FBIopeningUPP/air-split/docs/images/case_joined_top.png

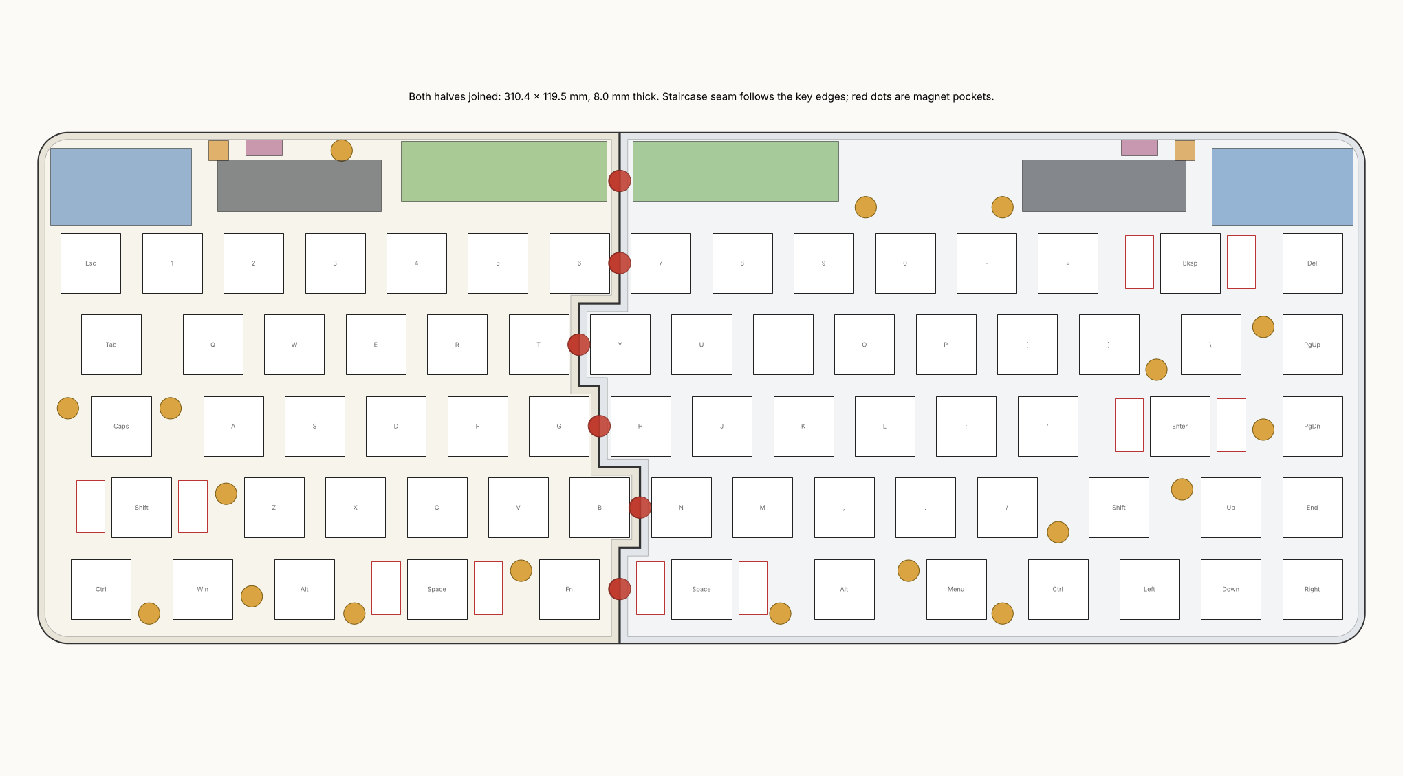
docs/images/case_joined_top.png
