FBIopeningUPP/air-split/docs/images/case_left_top.png

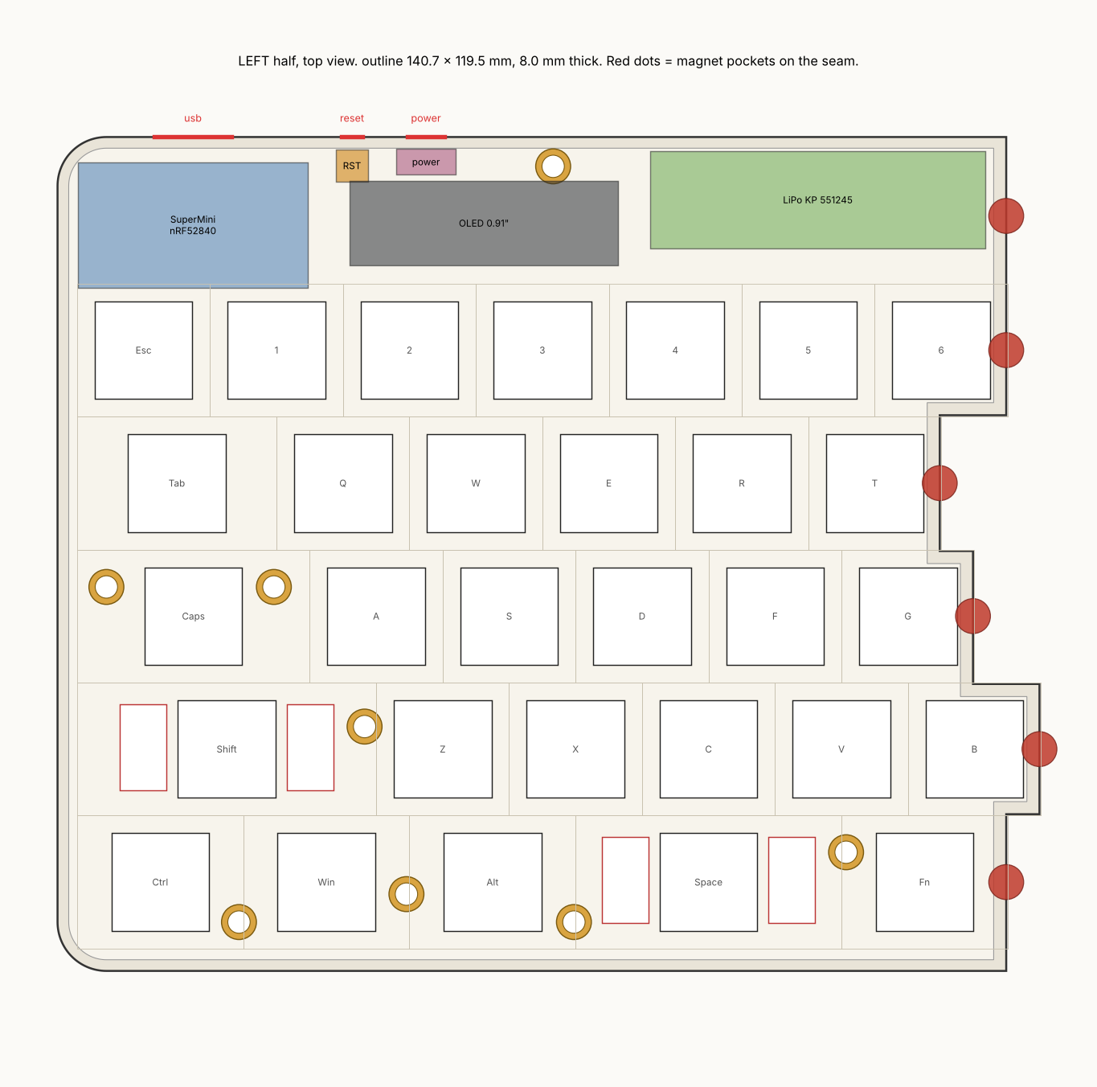
docs/images/case_left_top.png
