FBIopeningUPP/air-split/docs/images/case_right_top.png

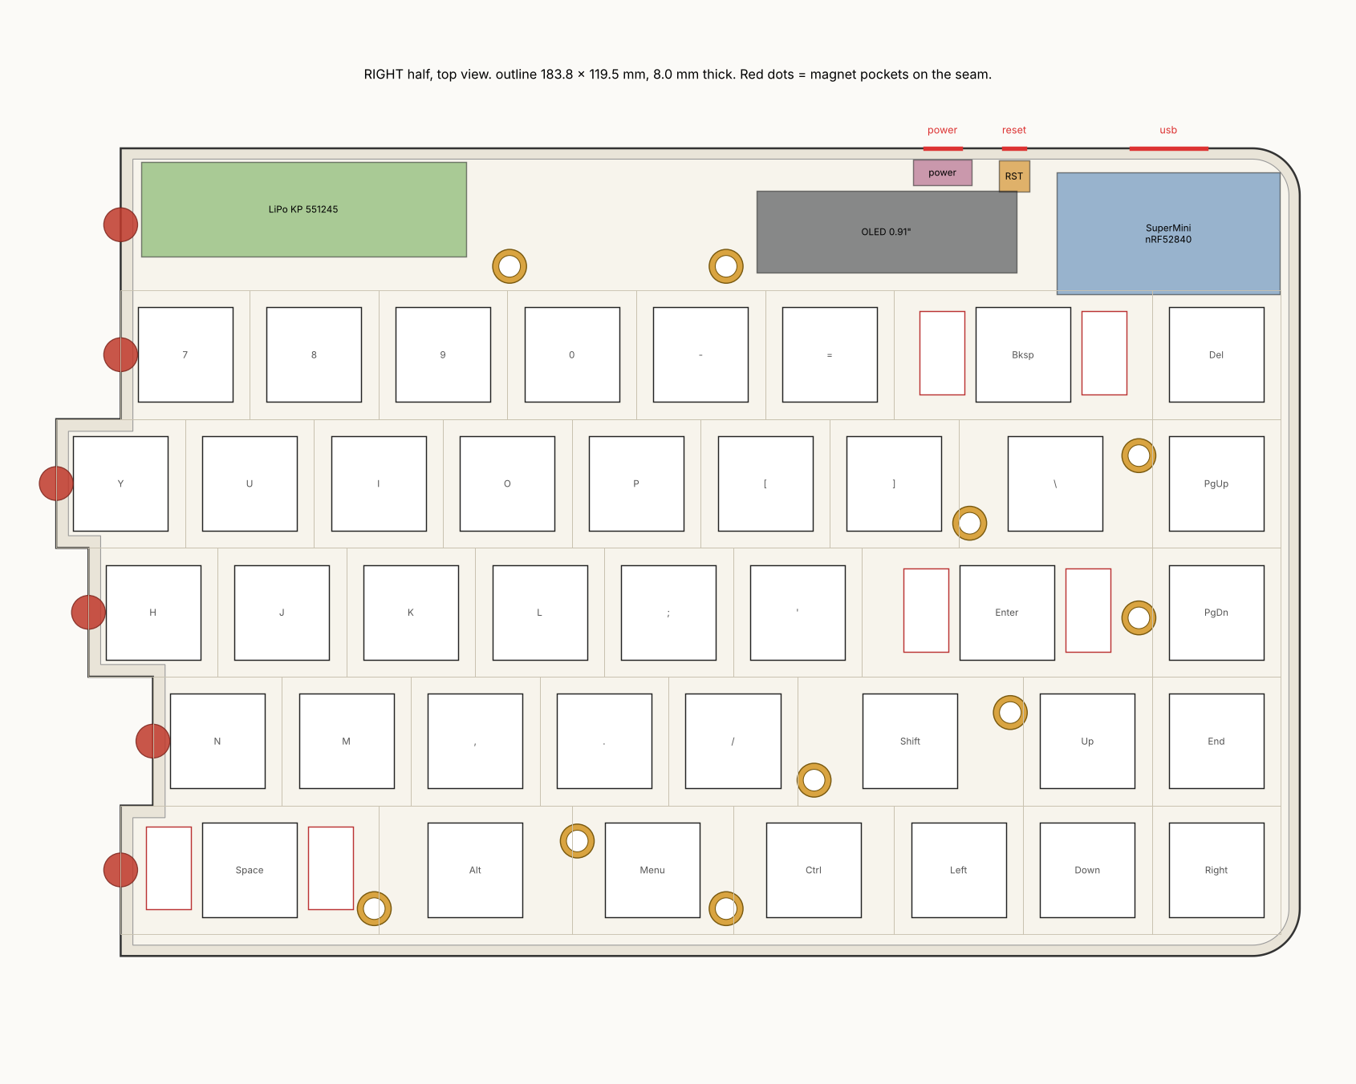
docs/images/case_right_top.png
