FBIopeningUPP/air-split/docs/images/hero.jpg

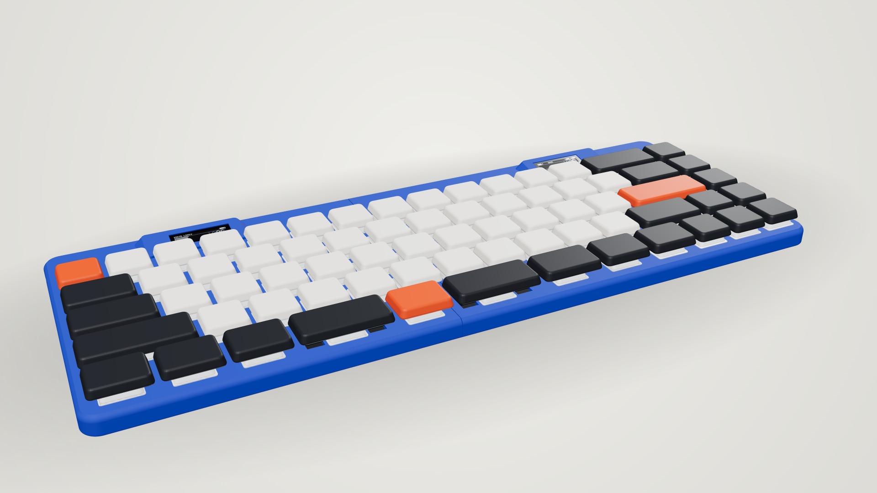
docs/images/hero.jpg
