FBIopeningUPP/air-split/docs/images/thickness_profile.png

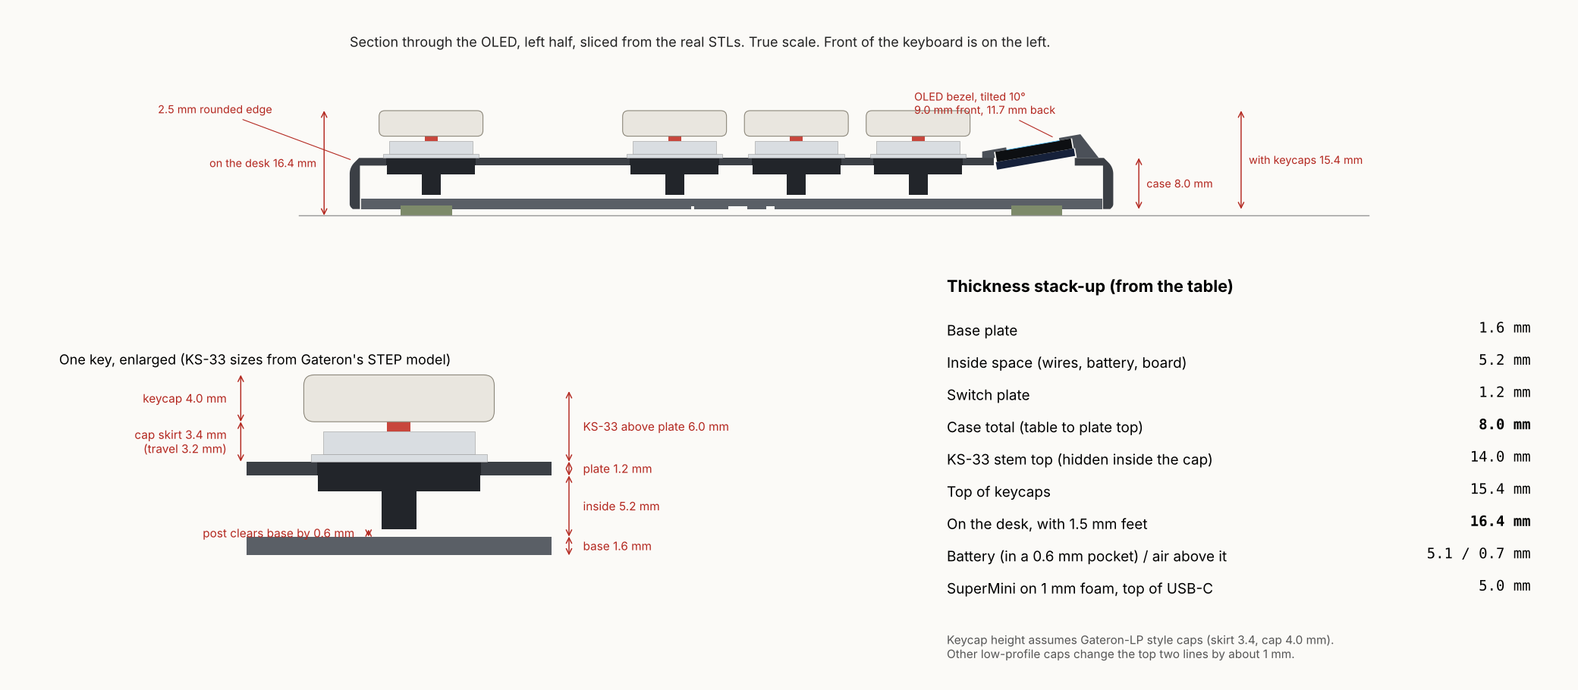
docs/images/thickness_profile.png
