FBIopeningUPP/air-split/models/step/left_base.step

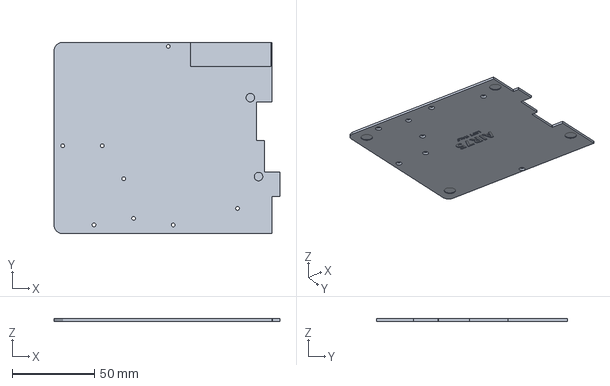
[picture p21: CAD file, 2026-10-18]
models/step/left_base.step
137.0 x 115.9 x 1.60 mm
