FBIopeningUPP/air-split/models/step/right_tent_15.step

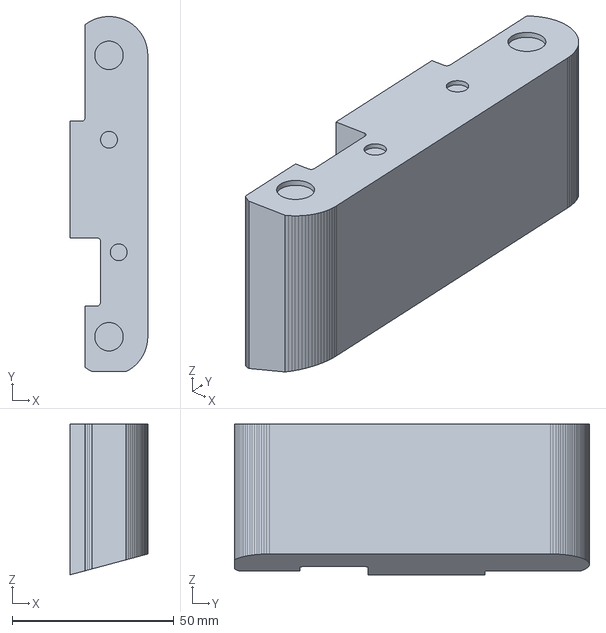
[picture p22: CAD file, 2026-10-18]
models/step/right_tent_15.step
24.0 x 109.8 x 46.6 mm
