FBIopeningUPP/air-split/models/step/left_tent_10.step

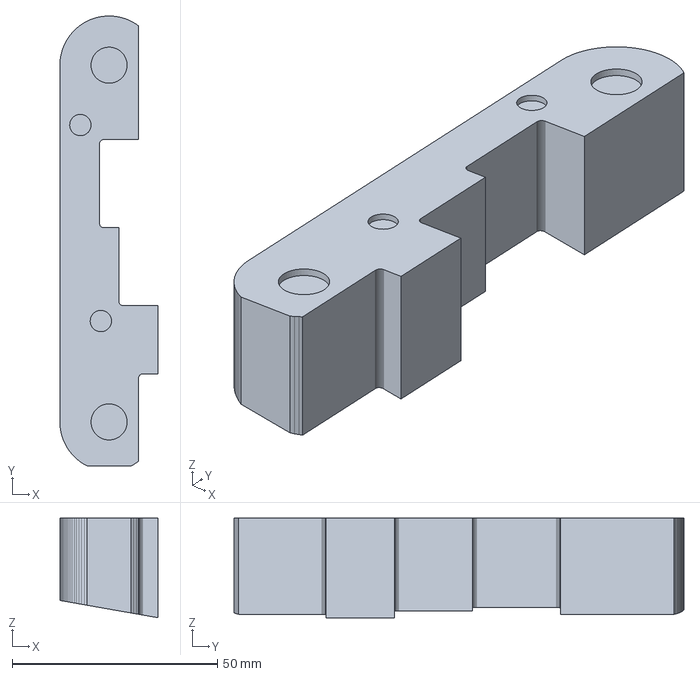
[picture p23: CAD file, 2026-10-18]
models/step/left_tent_10.step
24.0 x 109.8 x 24.3 mm
