FBIopeningUPP/air-split/models/step/fit_test_plate.step

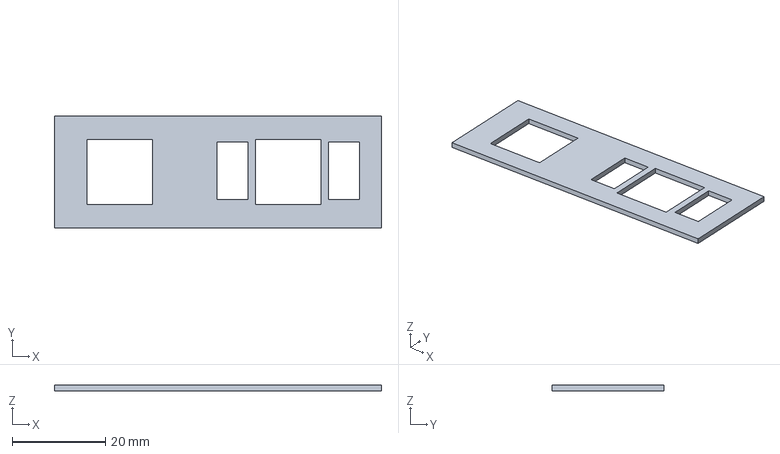
[picture p24: CAD file, 2026-10-18]
models/step/fit_test_plate.step
70.0 x 24.0 x 1.20 mm
