FBIopeningUPP/air-split/models/step/left_tent_15.step

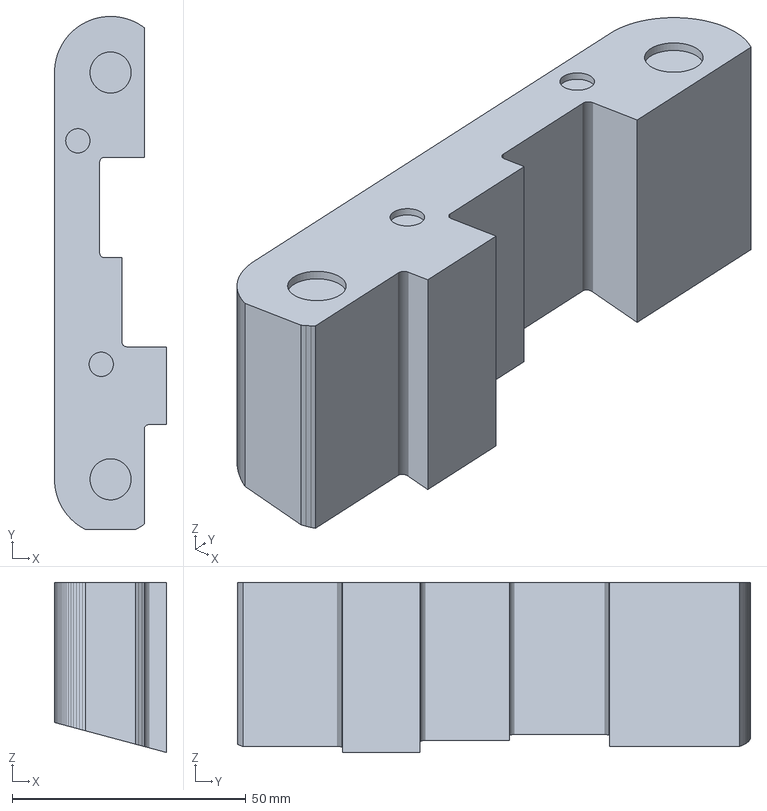
[picture p25: CAD file, 2026-10-18]
models/step/left_tent_15.step
24.0 x 109.8 x 36.4 mm
