FBIopeningUPP/air-split/models/step/left_tent_5.step

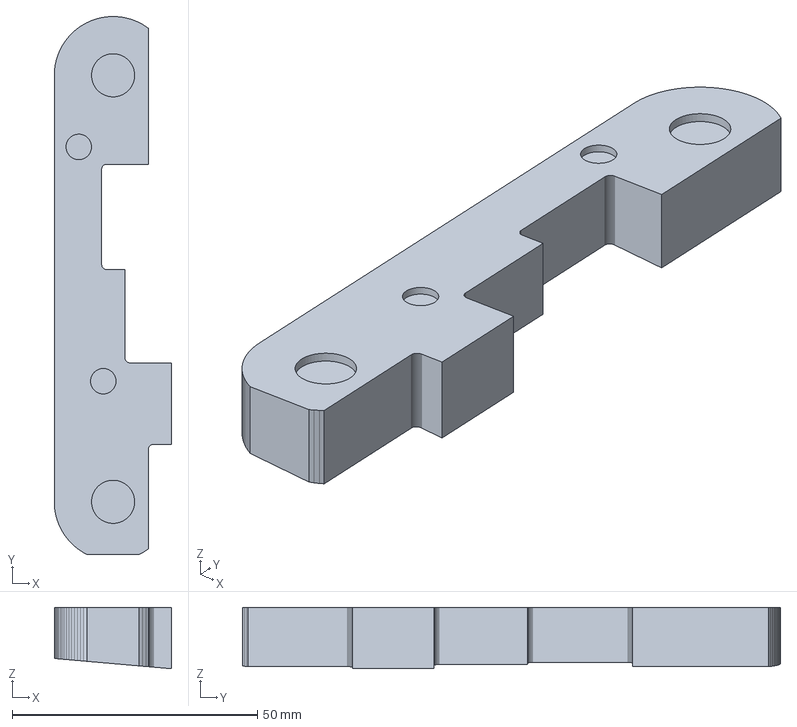
[picture p26: CAD file, 2026-10-18]
models/step/left_tent_5.step
24.0 x 109.8 x 12.5 mm
