FBIopeningUPP/air-split/models/step/left_cover.step

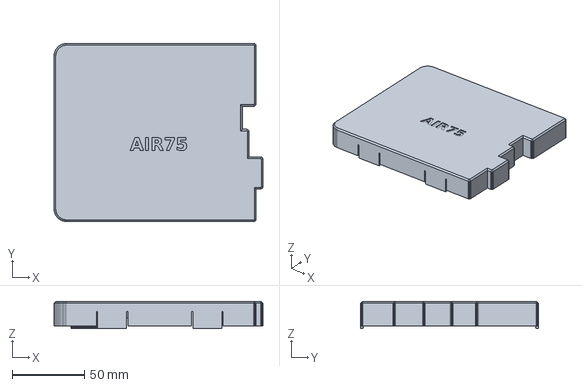
[picture p27: CAD file, 2026-10-18]
models/step/left_cover.step
144.4 x 123.2 x 18.7 mm
