FBIopeningUPP/air-split/models/step/right_cover.step

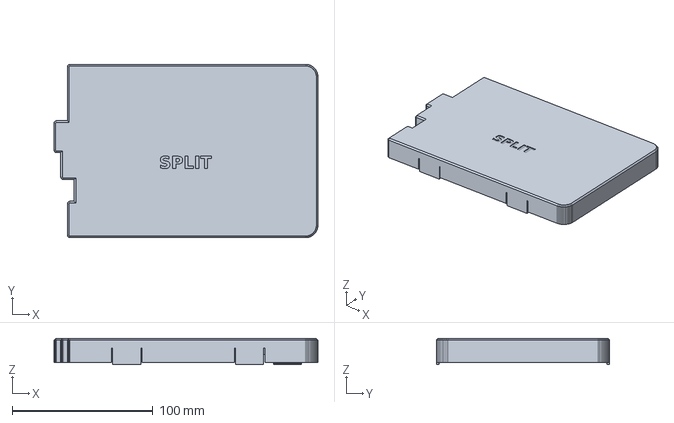
[picture p28: CAD file, 2026-10-18]
models/step/right_cover.step
187.5 x 123.2 x 18.7 mm
