FBIopeningUPP/air-split/models/step/right_oled_bezel.step

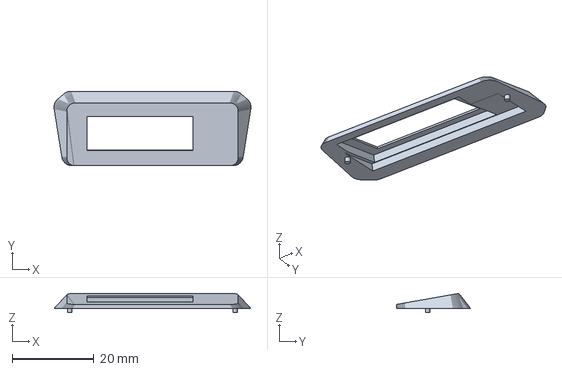
[picture p29: CAD file, 2026-10-18]
models/step/right_oled_bezel.step
48.3 x 18.2 x 4.71 mm
