FBIopeningUPP/air-split/models/step/right_shell.step

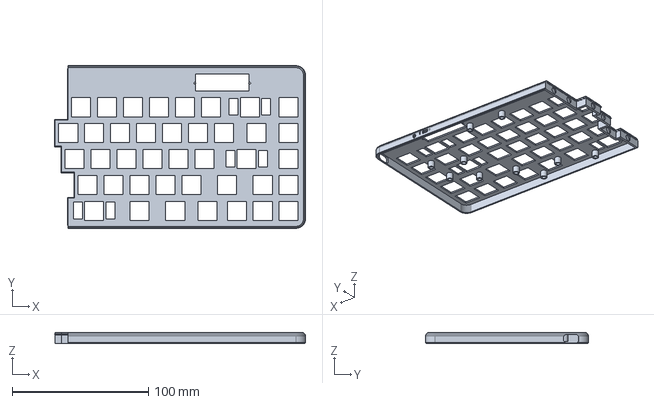
[picture p30: CAD file, 2026-10-18]
models/step/right_shell.step
184.3 x 119.4 x 8.00 mm
