FBIopeningUPP/air-split/models/step/right_tent_10.step

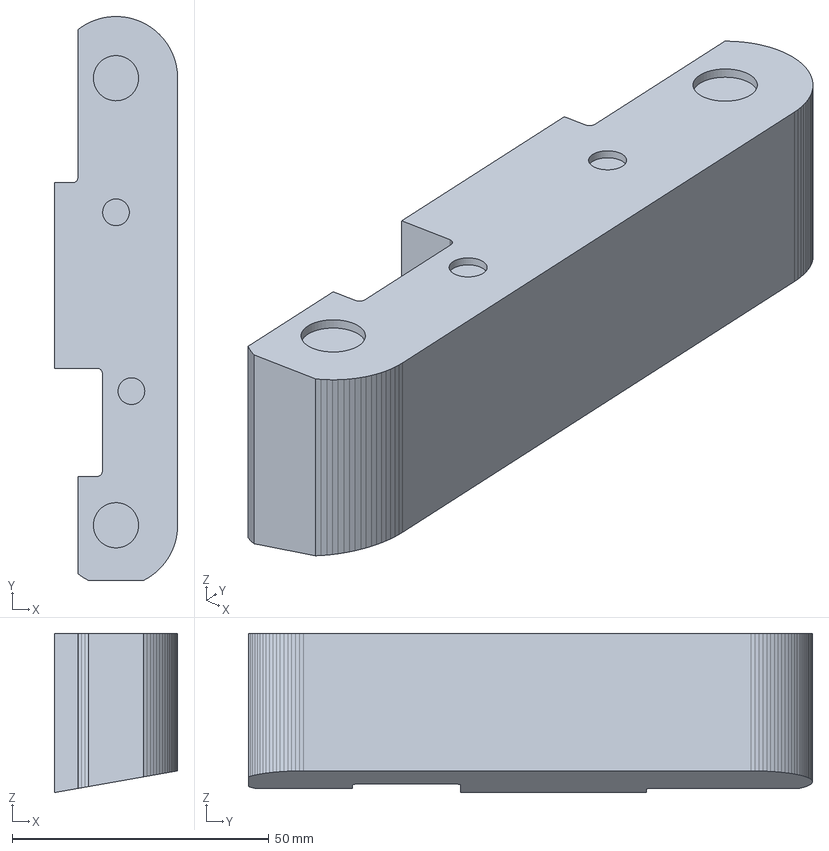
[picture p31: CAD file, 2026-10-18]
models/step/right_tent_10.step
24.0 x 109.8 x 31.0 mm
