FBIopeningUPP/air-split/models/step/left_shell.step

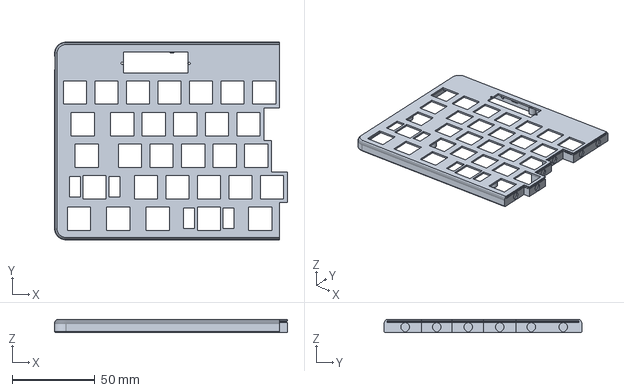
[picture p32: CAD file, 2026-10-18]
models/step/left_shell.step
140.7 x 119.4 x 8.00 mm
