FBIopeningUPP/air-split/models/step/right_base.step

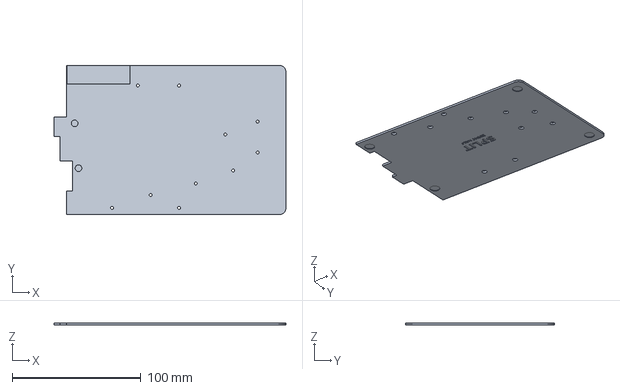
[picture p33: CAD file, 2026-10-18]
models/step/right_base.step
180.1 x 115.9 x 1.60 mm
