FBIopeningUPP/air-split/models/step/right_tent_5.step

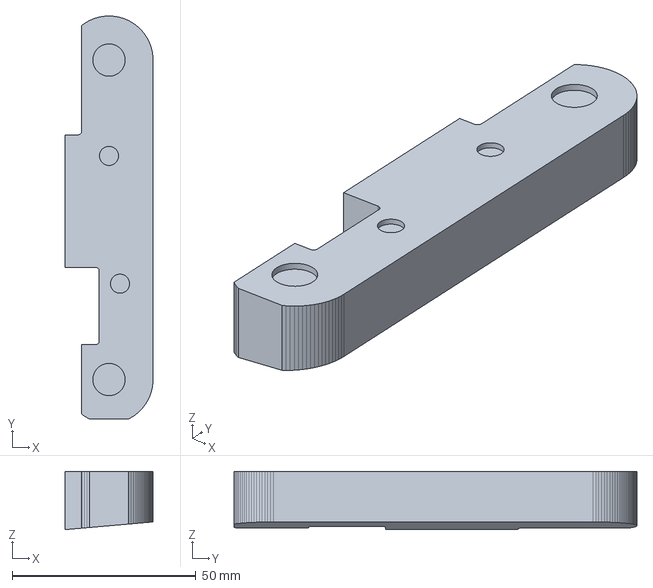
[picture p34: CAD file, 2026-10-18]
models/step/right_tent_5.step
24.0 x 109.8 x 15.9 mm
