FBIopeningUPP/air-split/(list of files, cad)

Other CAD files:
models/step/left_oled_bezel.step
models/print/fit_test_plate.stl
models/print/left_base.stl
models/print/left_cover.stl
models/print/left_oled_bezel.stl
models/print/left_shell.stl
models/print/left_tent_10.stl
models/print/left_tent_15.stl
models/print/left_tent_5.stl
models/print/right_base.stl
models/print/right_cover.stl
models/print/right_oled_bezel.stl
models/print/right_shell.stl
models/print/right_tent_10.stl
models/print/right_tent_15.stl
models/print/right_tent_5.stl
models/stl/fit_test_plate.stl
models/stl/left_base.stl
models/stl/left_cover.stl
models/stl/left_oled_bezel.stl
models/stl/left_shell.stl
models/stl/left_tent_10.stl
models/stl/left_tent_15.stl
models/stl/left_tent_5.stl
models/stl/right_base.stl
models/stl/right_cover.stl
models/stl/right_oled_bezel.stl
models/stl/right_shell.stl
models/stl/right_tent_10.stl
models/stl/right_tent_15.stl
models/stl/right_tent_5.stl
