FBIopeningUPP/air-split/docs/images/wiring_right.png

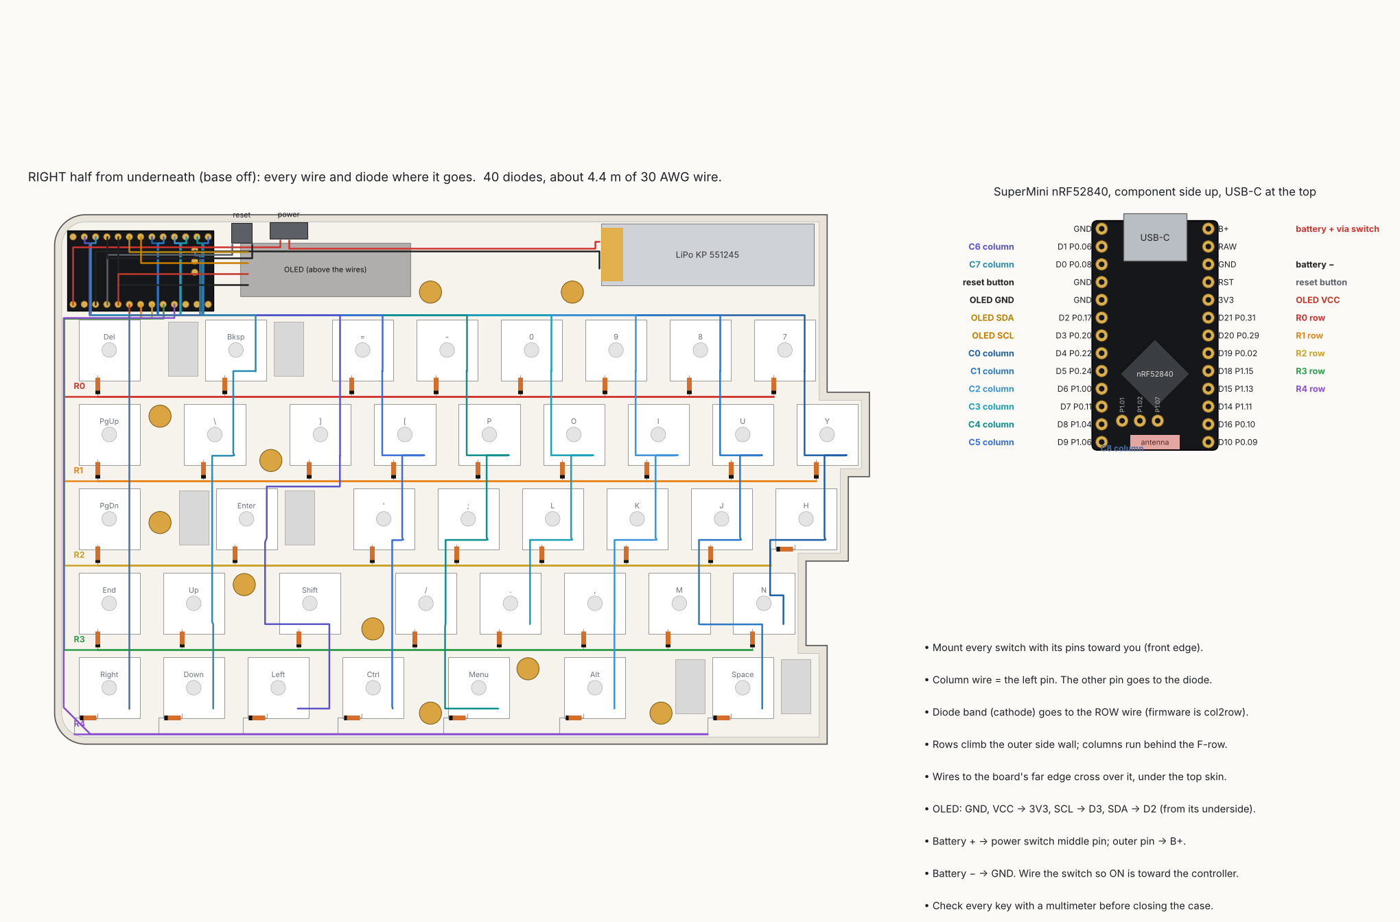
docs/images/wiring_right.png
