FBIopeningUPP/air-split/(commit log)

2026-10-18 Air75 Split: 70-key wireless split low-profile keyboard
    Smooth support-free case (teardrop edges, separate tilted OLED bezel), STL/STEP,
    routed wiring, ZMK config, 3D viewer and BOM.
    Claude-Session: https://claude.ai/code/session_014YQPJf7XcSFyfz4cMTj1QV
    [fit_test_plate.step, fit_test_plate.stl, left_base.step, left_base.stl, left_oled_bezel.step, left_oled_bezel.stl, left_shell.step, left_shell.stl]
2026-10-18 Smooth lofted case edges, verified firmware build, viewer polish
    - Case: the rounded top and bottom edges are now one lofted solid (a ring
    every 3 degrees) cut into the two halves, instead of 0.2 mm stair-step
    slices. STEP files carry real arc/conical faces. OLED bezel ends use 10
    slices instead of 5. All checks pass, no supports needed, volumes unchanged.
    - Firmware: compiled left, right and settings_reset against ZMK v0.3 and
    added the .uf2 files under firmware/. Enabled the WPM widget on the right
    OLED (off by default in ZMK). Moved the central-only battery settings to
    the right half's config so the left build has no config warnings.
    - Viewer: crease-angle shading for printed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
    [fit_test_plate.step, left_base.step, left_base.stl, left_oled_bezel.step, left_oled_bezel.stl, left_shell.step, left_shell.stl, right_base.step]
2026-10-18 Tapered OLED bezel, close the bezel slit and seam gaps, rounded USB-C opening
    - OLED bezel: the outside is now one tapered pod (convex hull of a rounded
    top face and a rounded footprint): ends slope down onto the deck at 48
    degrees, the back at 58 degrees. Both stay steep enough to print
    window-face-down without supports (0.0 mm2 overhang).
    - Fixed a slit along the bottom of the bezel's back wall: the PCB pocket,
    cut along the 15 degree tilt, broke out of the old vertical back wall
    between 8.0 and 8.4 mm. The sloped back keeps the wall solid to the deck.
    - Fixed a small diamond-shaped hole where the seam meets the front and back
    faces: the V groove and tongue now stop 1.6 / 2.0 m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
    [fit_test_plate.step, left_base.step, left_oled_bezel.step, left_oled_bezel.stl, left_shell.step, left_shell.stl, right_base.step, right_oled_bezel.step]
2026-10-18 Animated OLED screens in the firmware, mirrored in the viewer
    - New custom ZMK status screen (zmk-config/src/air75_oled):
    right half: spectrum-analyzer bars that jump where you type, peak
    dots, a big seven-segment WPM counter with faintly lit unused
    segments, Bluetooth profile and link, layer (inverted FN tag) and both
    batteries. Left half: a live map of its 30 keys that fill and fade,
    sonar ripples from every press, link status and battery in big digits.
    Both play a short AIR75 boot sweep.
    - render.c is pure integer C with no ZMK/LVGL dependency; status_screen.c
    queues key events, polls status and copies only changed pixels to an
    LVGL canvas. Redraws only while something mov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
    [fit_test_plate.step, left_base.step, left_oled_bezel.step, left_shell.step, right_base.step, right_oled_bezel.step, right_shell.step]
2026-10-18 Viewer: live screen panel, visible start-up errors, no reliance on global this
    - Both OLED screens now show at readable size in a panel under the title
    (quarter-size of the 1024 px texture so the pixel grid stays clean), so
    the display is visible without opening the close-up.
    - The page types "air75 split" by itself shortly after loading (stops as
    soon as the viewer touches anything), so the screens show what they do.
    - oled_render.js attaches to globalThis instead of the top-level this,
    which is undefined in some embedded runtimes.
    - If a script fails to load or throws before the model is built, the page
    says what failed instead of staying blank.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
2026-10-18 Viewer: fix the model staying out of view when the page starts at zero size
    When the viewer loaded inside a frame that had no size yet (the artifact
    panel opening), the camera framing divided by a zero aspect ratio and put
    the camera at infinity; resizing later never re-framed it, so the panel
    and screens showed but the keyboard did not. The framing now falls back
    to 16:9 at zero size, re-frames on the first real size, and resets the
    view if the camera ever ends up at a non-finite position.
    Claude-Session: https://claude.ai/code/session_01V8DPTNKmii4MkE2SfbrDGm
2026-10-18 Snap-on key covers, night mode with glowing screens, showcase view
    Key covers (case/covers.py, built in OpenCascade):
    - One per half: 1.6 mm top 1.0 mm above the keycaps (no key pressed in a
    bag), skirt 0.25 mm off the case wall, four snap tabs on flex slots whose
    hooks follow the case's rounded bottom edge and reach 0.42 mm under it.
    - 45 degree chamfered top edge, AIR75 / SPLIT pressed into the tops, notch
    for the power switch and reset hole, room for the right half's V tongue.
    - Prints top face down with no supports; tabs stay above the desk.
    - verify.py: covers watertight, no overlap with case or bezel, clear of the
    keycaps, every hook engages, tabs above the desk, switch reachab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
    [fit_test_plate.step, left_base.step, left_cover.step, left_cover.stl, left_oled_bezel.step, left_shell.step, right_base.step, right_cover.step]
2026-10-18 Slimmer screen pods, tighter side borders, engraved underside
    - OLED pods: tilt 15 -> 10 degrees, so the back edge drops from 13.0 to
    11.7 mm above the desk (front edge still 9.0 mm). The bezel check now
    asks for a real tilt rather than a 15 degree one.
    - Side border around the keys 3.2 -> 2.8 mm (the tightest the row wires
    climbing the side walls allow: 2.6 mm gives 19 clearance problems per
    half); the front keeps 3.2 mm for the bottom row's wire. The joined
    board is 310.4 mm wide instead of 311.2 mm; case thickness unchanged.
    - Base underside: AIR75 / SPLIT and LEFT HALF / RIGHT HALF engraved
    0.4 mm deep, placed clear of screws and feet, prints without supports.
    - Covers, wirin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
    [fit_test_plate.step, left_base.step, left_base.stl, left_cover.step, left_cover.stl, left_oled_bezel.step, left_oled_bezel.stl, left_shell.step]
2026-10-18 Magnetic tenting wedges (5, 10, 15 degrees)
    - case/tents.py: one wedge under the inner edge of each half. It sockets
    over the two inner rubber feet (no sliding) and holds on with two 5 x 1
    mm magnets that pull on two magnets hidden in pockets on the inside face
    of the base, under 0.5 mm of plastic. The half pivots on the outer edge
    of its outer feet; the wedge's underside is the desk plane for its angle.
    - Lifts the inner edge 12/15, 23/31 or 36/47 mm (left/right).
    - Prints top face down without supports.
    - verify.py: base magnet pockets present with skin intact, every wedge
    watertight, no overlap with base, shell or rubber feet, flat on the desk
    at its angle, magnets aligned, an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
    [fit_test_plate.step, left_base.step, left_base.stl, left_cover.step, left_oled_bezel.step, left_shell.step, left_tent_10.step, left_tent_10.stl]
2026-10-18 BOM: battery link with stock check, keycaps are printed
    Link the KP 551245 battery to Zbotic's micro LiPo list (SKU AI6793,
    listed in stock, checked 18 Oct 2026) and show the stock status in the
    parts list. Keycaps move from bought to printed.
    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
2026-10-18 Organize the repo, showcase README with renders, full build guide
    - New layout: cad/ (generator), models/{print,stl,step}, firmware/ (prebuilt
    .uf2 + zmk-config/), docs/ (BUILD.md + images), viewer/, bom/.
    All scripts take their paths from cad/paths.py; intermediate data goes to
    build/ (not committed).
    - Makefile runs the whole pipeline (make, make renders); requirements.txt.
    - README.md is now a showcase with renders from the 3D viewer: hero shot,
    OLED close-up, split and tented, slim profile, cutaway, exploded, inside,
    wiring, travel covers, colourways and a turntable GIF. The full guide
    moves to docs/BUILD.md; both are generated from the model by guide.py.
    - viewer/render.js d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
    [fit_test_plate.step, fit_test_plate.stl, left_base.step, left_base.stl, left_cover.step, left_cover.stl, left_oled_bezel.step, left_oled_bezel.stl]
2026-10-18 README: light and dark renders that blend into GitHub, labelled exploded view, badges
    Every render now comes in a light and a dark version matching GitHub's page
    colours, swapped with <picture> so the images sit on the page instead of in
    grey boxes. The exploded view labels each part. viewer/render.js renders each
    shot once and composites it over both backgrounds; it can also make split,
    covers and turntable GIFs (make renders).
    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
    [readme.py]
2026-10-18 Name it Snap70; add a banner for posts
    Snap70: 70 keys, and the halves snap together on magnets (Air75 suggested 75
    keys). The README, build guide, viewer and parts list use the new name. The
    firmware's Bluetooth name, the OLED boot screen and the cover engraving still
    say Air75 until the firmware is rebuilt.
    docs/images/banner.jpg: title, pills and the two halves in cream with dark
    modifiers and orange accents (node viewer/render.js banner).
    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
    [guide.py, readme.py]
2026-10-18 Banner: cobalt blue case so it pops, with the orange accents
    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
2026-10-18 README in the style of corne-lp-handwired: stats strip, feature cards, colourways
    - Renders on one warm studio background, with two-tone keycaps (ink
    modifiers, orange accents) on a cobalt case.
    - stats.png: big-number strip; colorways.jpg: six labelled colourway tiles
    (viewer/compose.py).
    - Feature cards: slim profile, OLED close-up, split-and-tent GIF, covers GIF.
    - Captioned gallery, screens section, build steps, keymap, collapsed repo map,
    3D viewer, make it yours, credits.
    - Viewer: switching from Covers to another view now hides the covers.
    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
